OlegMishin/A1200_keyb_MPU/doc/PCB_view.JPG

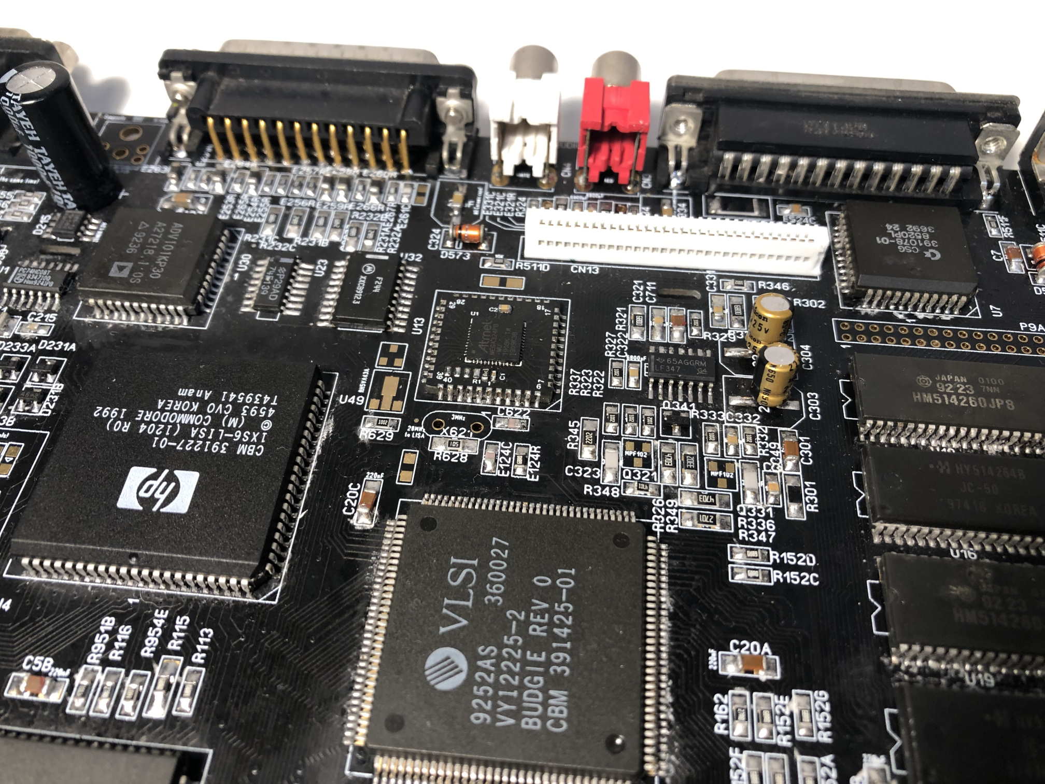
doc/PCB_view.JPG
