OlegMishin/A1200_keyb_MPU/doc/A1200_keyb_mpu_FW_download.pdf

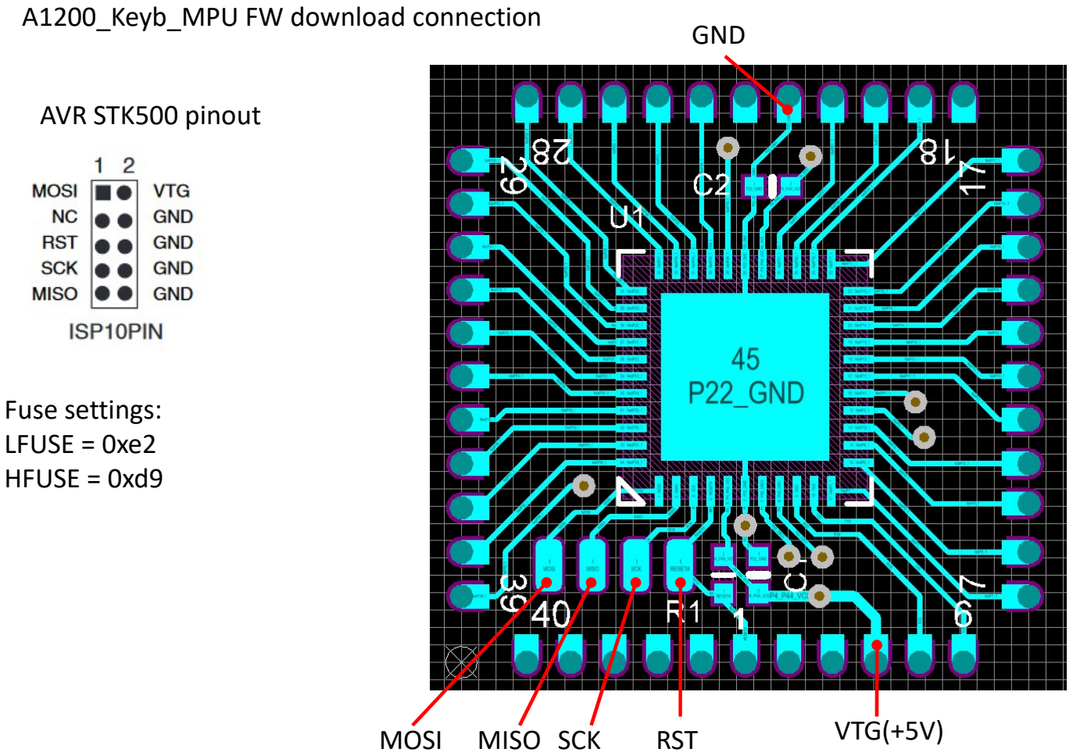
[picture p2: page 1]

AVR STK500 pinout

GND A1200_Keyb_MPU FW download connection

MOSI MISO SCK | RST | VTG(+5V)

Fuse settings:
LFUSE = 0xe2
HFUSE = 0xd9
