OlegMishin/A1200_keyb_MPU/doc/A1200_keyb_mpu_pcb_trimming.pdf

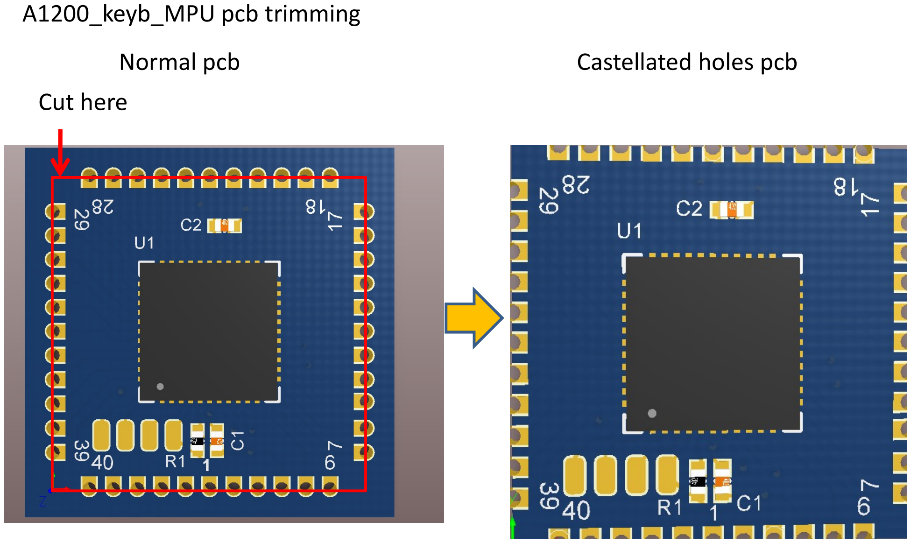
[picture p3: page 1]

Cut here

A1200_keyb_MPU pcb trimming
Normal pcb | Castellated holes pcb
