OlegMishin/A1200_keyb_MPU/doc/keymap.gif

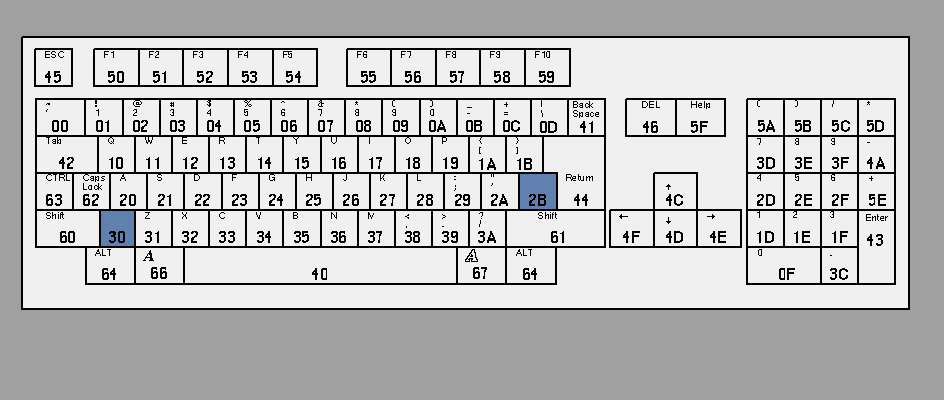
doc/keymap.gif
