OlegMishin/A1200_keyb_MPU/doc/A1200_keyb_MPU_sch.PDF

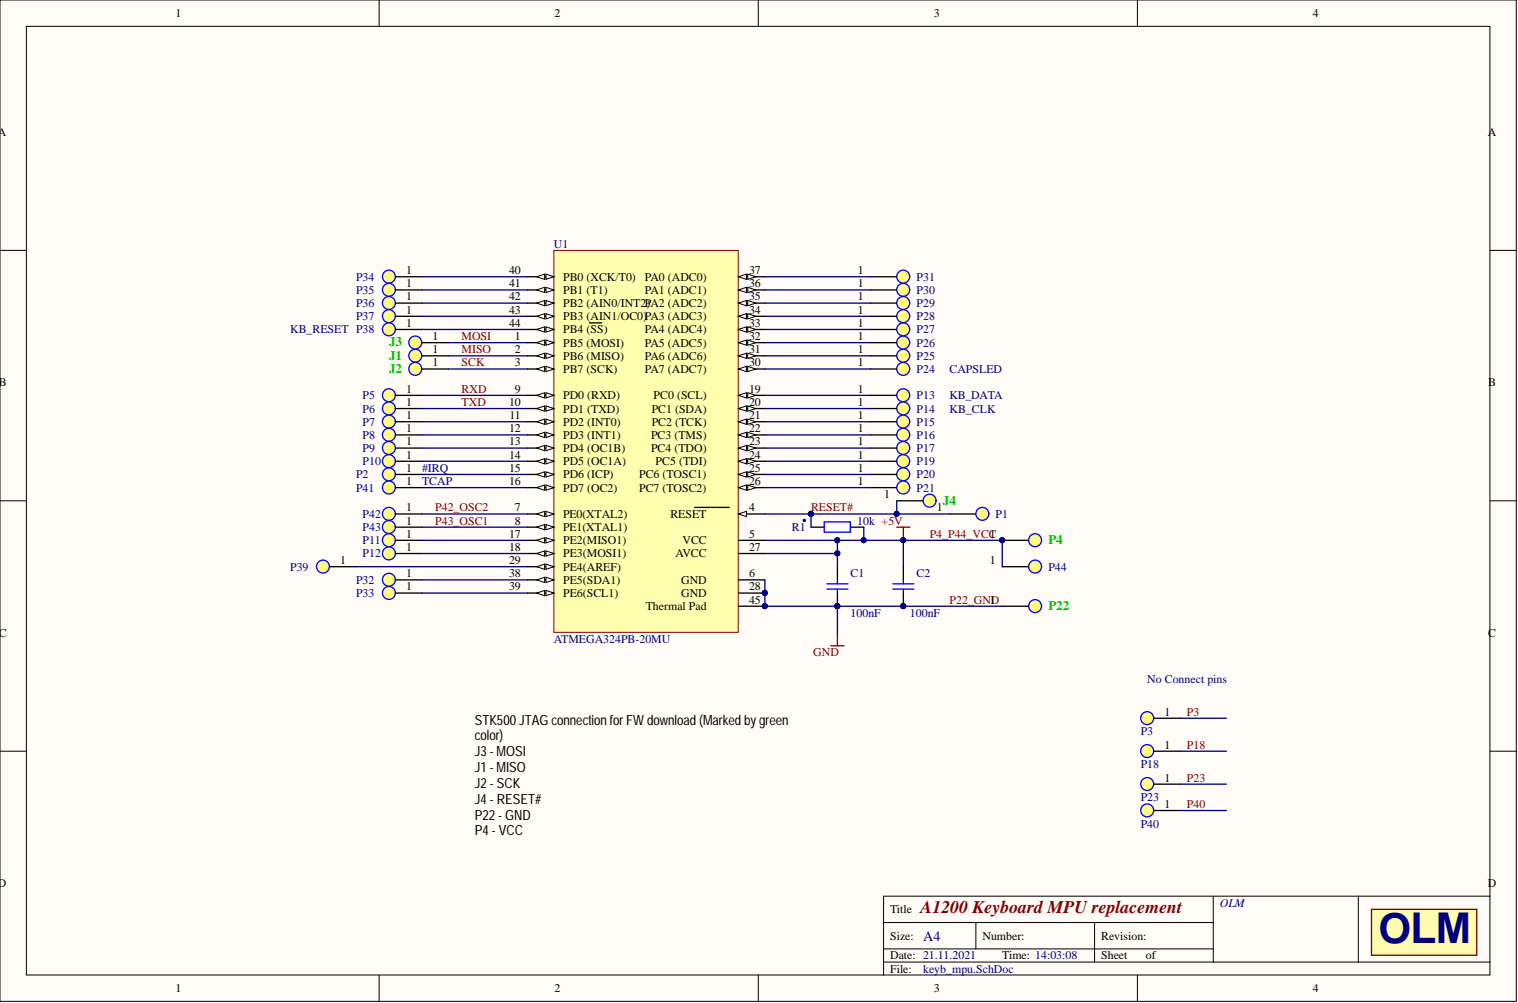
[picture p5: page 1]

Title | OLM A1200 Keyboard MPU replacement

Size: | Number: | Revision:
Date: 21.11.2021 Time: 14:03:08 | | Sheet of
