OlegMishin/A1200_keyb_MPU/(threads)

Thread 1 (2023-11-15):

current status?

chucktastic, 2023-11-15:
I'm building one of these MPU replacements due to a lack of other original and affordable options.  Is this fully functional?  I had to order a half dozen PCBs from a board house.  Would it be ok to sell the ones I don't use on ebay as long as I give credit?

Thanks!

OlegMishin, 2023-11-17:
Hi,
It works at least in one my A1200 board. So far no issues.
You can sell remaining boards, It is ok for me.

BR

chucktastic, 2023-11-17:
Thanks so much!  What size SMD resistor and capacitors did you use?  The first one I built with 0201.  While I got them on they're freakishly tiny and time consuming to fit.

OlegMishin, 2023-11-18:
No problem :)
I used 0402 size components.
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

Closed 2025-04-04.

Thread 2 (2024-01-29):

Package sized passive components

imqqmi, 2024-01-29:
Hi,

Nice project! I'm in the process of ordering parts for this. What are the smd sizes for the caps and resistors? It seems 0402 or something but I'm not sure.

OlegMishin, 2024-01-29:
Hi,
Thanks! I used 0402 passive components. But it is possible to solder 0603 using solder paste, hot air gun and some luck :)

Closed 2025-04-04.

Thread 4 (2025-02-05):

Castellated holes support for Aisler

Feliksas, 2025-02-05:
Greetings!
EU PCB manufacturer Aisler requires user-defined bridges to properly detect castellated holes https://community.aisler.net/t/castellated-edges/48 - basically, it means that there needs to be a separate layer present, with drawn lines that specify bridge positions - there is their manuan on how to define those: https://community.aisler.net/t/custom-bridges-and-frames/49. Is there any chance you could produce a separate Gerber output with these additions, so that the boards could be ordered at Aisler? I would be very grateful :)

OlegMishin, 2025-04-04:
Hi,
Sorry, due to lack of time I do not plan to update the pcb files.
If needed, it can be done in any Gerber editor.
Alternatively,  the board can be ordered at another supplier. e.g. Jlcpcb(my favorite).

Regards
Oleg

Thread 5 (2025-04-03):

Alternative to ATMEGA324PB-20MU?

julmust4life, 2025-04-03:
Hi!
1.
I have a hard time finding the microchip with the exact model no:
ATMEGA324PB-20MU
I've found:
ATMEGA324P-20MU
Do you know if that that will be ok to use?

2.
Is it possible to (re)programe the chip when the A1200_keyb_MPU pcb is soldered to the a1200 motherboard or does it need to be done before soldering it to the motherboard?

Thanks in advance! (awesome project!)

OlegMishin, 2025-04-04:
Hi,
Seems Microchip changed marking. You can easily find ATMEGA324PB-MU.
The chip can be programmed on the board. You need to supply it first.

Thread 6 (2025-10-05):

Implement on ReAmiga directly

ChuckyGang, 2025-10-05:
Would you accept me to implement this MPU solution directly on the ReAmiga 1200 PCB?

OlegMishin, 2025-10-05:
Hi John,

At first, let me thank you so much for the great ReAmiga project. I still enjoy the built one :)

Sure, feel free to integrate it to the ReAmiga board. I would appreciate if you let me know when you are ready to publish its Gerbers.

Kind regards
Oleg
